dadit97/Razorback-Project/README.md

# Razorback Project
University project consisting of an Arduino controlled tank model

### Main Features

- LED lights
- Dynamic sound system
- Rotating turret
- Turret firing LEDs
- Programmable path to follow autonomously
- Bluetooth controlled

[Link to Overview](https://github.com/dadit97/Razorback-Project/blob/master/Documentation/Overview.md)<br>
[Link to Arduino code](https://github.com/dadit97/Razorback-Project/blob/master/Code/BluetoothController/BluetoothController.ino)<br>
[Link to Circuit Schema](https://github.com/dadit97/Razorback-Project/blob/master/Circuit%20Schema/Schema.md)
