dadit97/Razorback-Project/Documentation/Overview.md

# Table of contents

- [Introduction](#Introduction)
- [Model construction](#Body)
- [Sound System](#Sound)
- [Motors System](#Motors)
- [Power Source](#Power)
- [Compass module](#Compass)
- [Microcontroller](#Microcontroller)
- [Other components](#Other)

## Introduction 

The idea is to create a dynamic model of the Sci-Fi Armoured Personnel Carrier Razorback, from the WarHammer 40,000 game series.

|**Model to reproduce**|
|:--:|
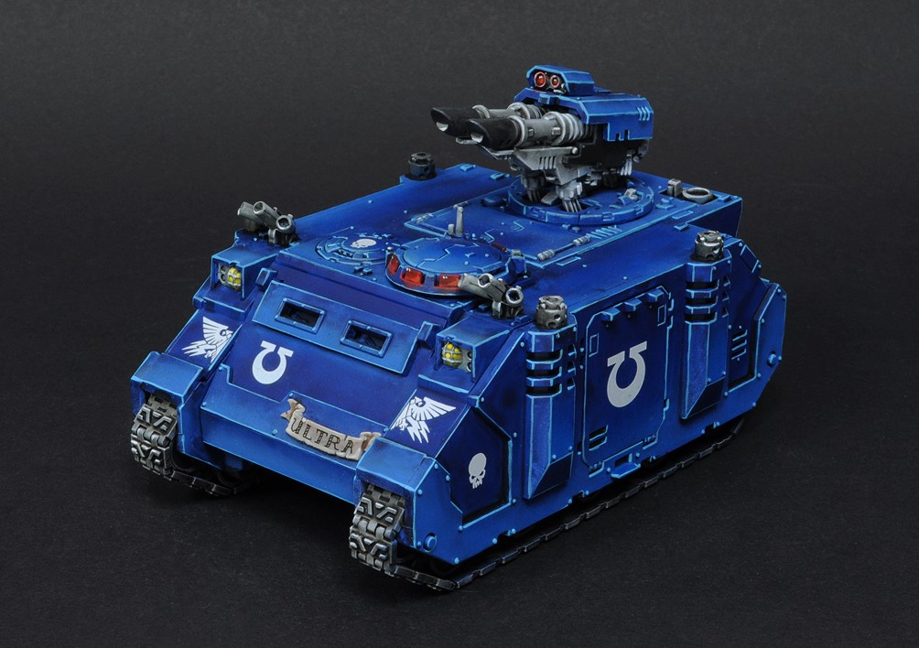
[picture p1: Images/Razorback.jpg]
||

The model, in addiction to being remotely controlled, should be able to follow a path he was instructed to patrol, using a compass as navigation aid and a distance sensor to avoid collisions.
This is an electronic project, so, the model will be simplified to some extent, but the objective is to create something that looks pretty similar.

## Model construction 

To build the chassis, the protection plates and the wheels I used some woodworking machines that I have access to. The dimensions have been estabilished by scaling some images knowing the total length and width of the model.

|**Main structure**||
|:--:|--|
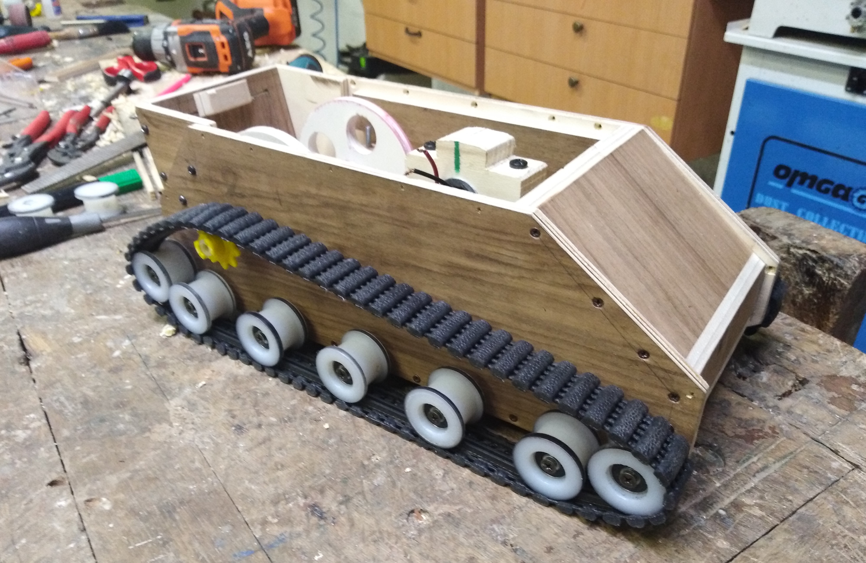
[picture p2: Images/Main_Structure.jpg]
||Inside the structure two pulleys were placed to reduce the speed of the main motors, these will transmit the power to the geared wheels,which were taken from an old Meccano kit. A structure to hold the motors in place has been installed in the middle of the body.|

|**Distance Sensor**||
|:--:|--|
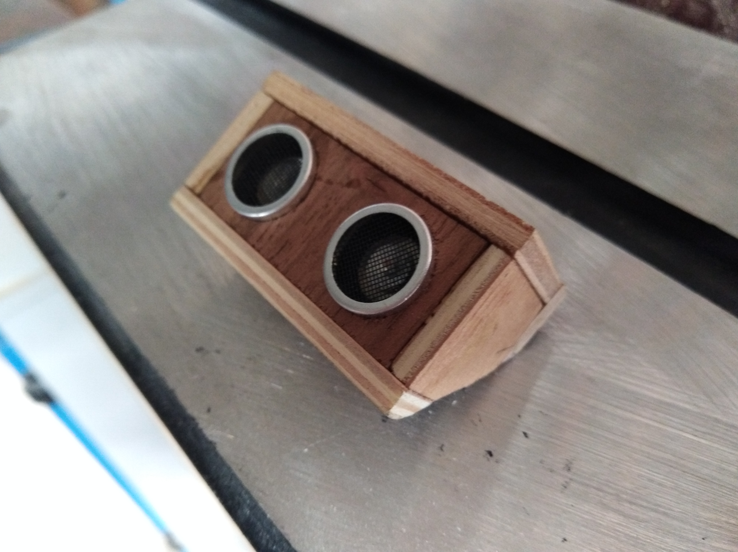
[picture p3: Images/Incapsulated_Sensor.jpg]
||The distance sensor had to be placed on the front, so it was closed in a proper case.|

Then the turret was built creating the servomotor housing inside and creating room for the firing LEDs. Unfortunately, the micro servo doesn't have a robust axle, so the connection is not the best, but for its purpose is enough.

The remaining of the building work were just the various decorations to make it similar to the target.

|**Components used and result after spray painting**|
|:--:|
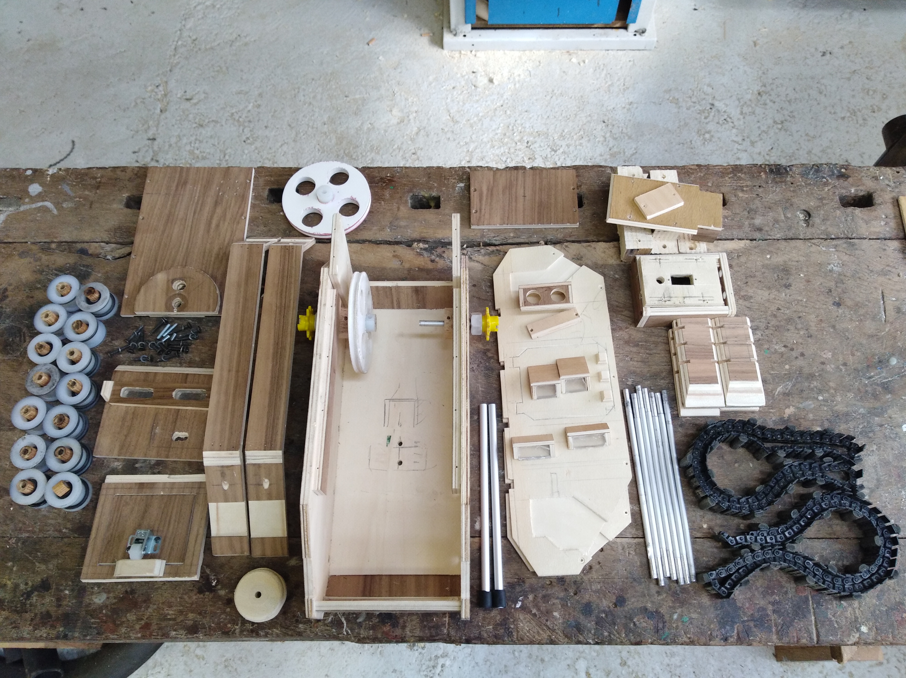
[picture p4: Images/Pieces.jpg]
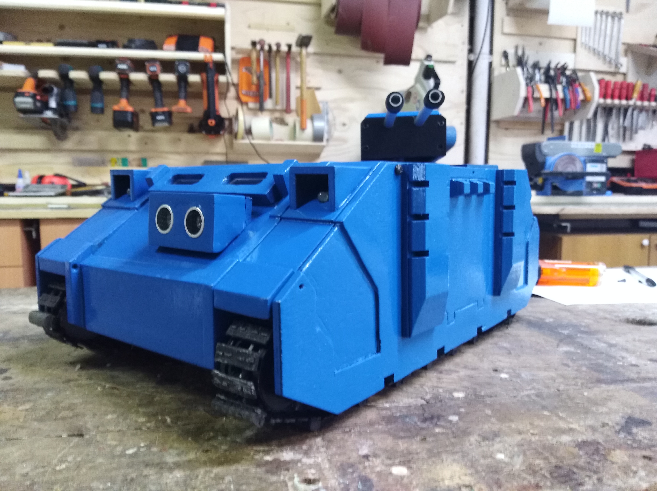
[picture p5: Images/Result.jpg]
|  |

|**Final aspect with lights on**|
|:--:|
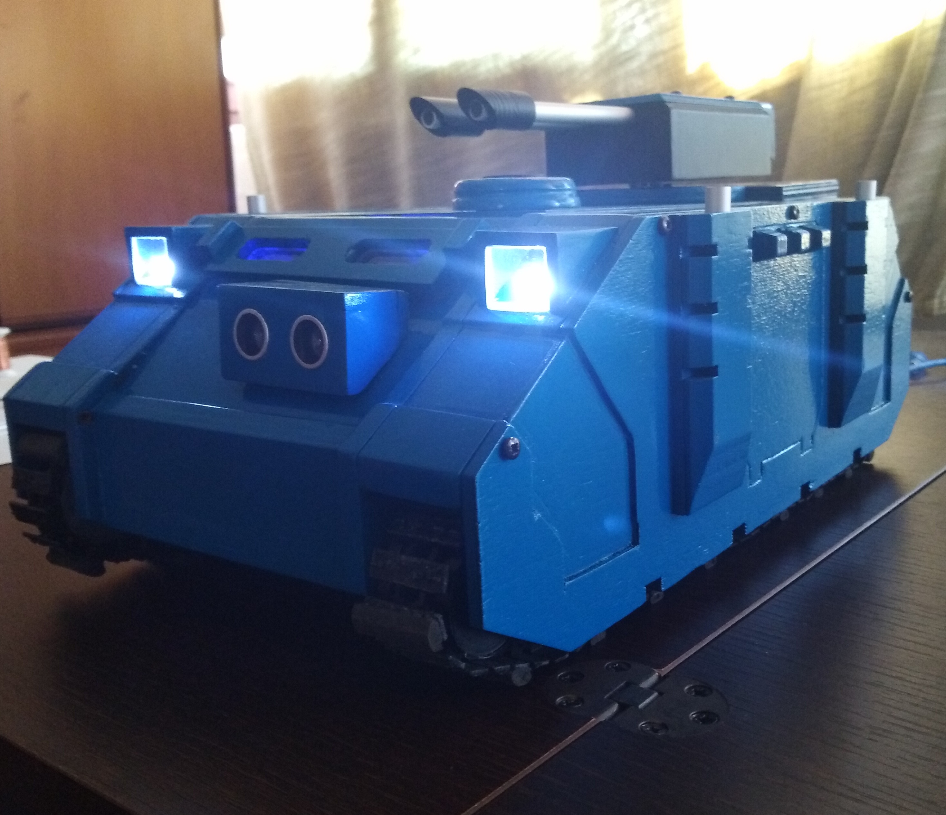
[picture p6: Images/Final_Front.jpg]
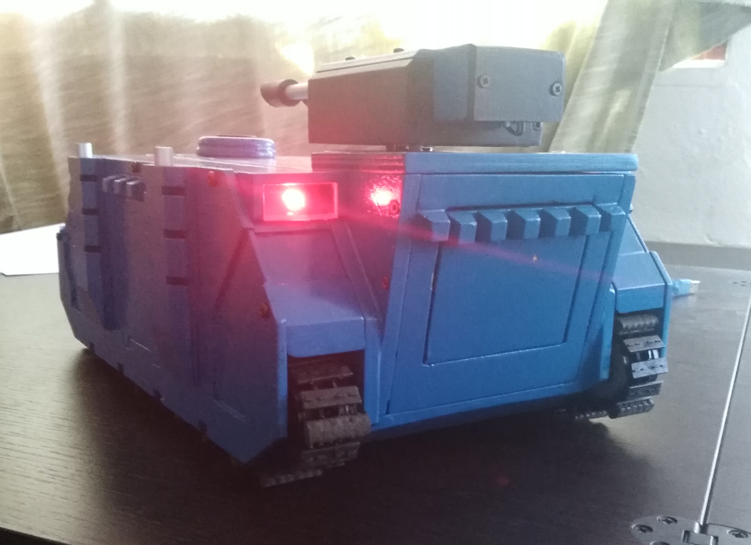
[picture p7: Images/Final_Back.jpg]
|  |

## Power Source 

|**Battery**||
|:--:|--|
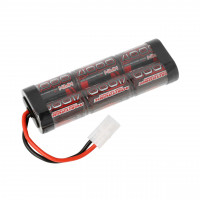
[picture p8: Images/Battery.jpg]
||The model will be powered up by a rechargable NI-MH 7.2V battery.|

## Sound System 

|**MP3 module**|**Speaker**||
|:--|:--:|--:|
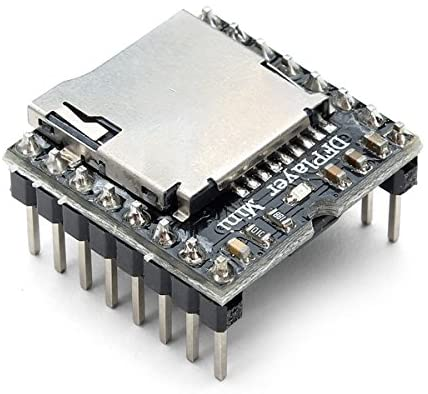
[picture p9: Images/DF_Mini.jpg]
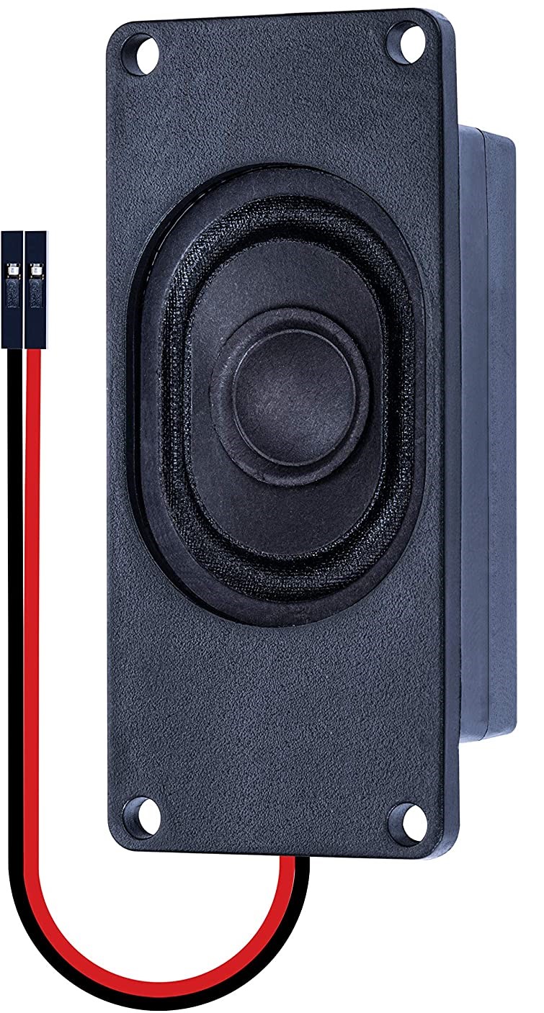
[picture p10: Images/Speaker.jpg]
| ||To create the illusion of the engine rumble, a MP3 module has been added to the control system, connected to a tiny 3W speaker, which is the maximum power that the module can supply without an amplifier.|

The module will be instructed by the Arduino using Serial communication, which will change the sound to be reproduced to suit the state of the model.
The storage of the module is a microSD card, in which the looped sounds were loaded.

## Motors System 

At the beginning of the project, the propulsion was based on two small 3-6V DC motors, but during the construction, the model's weigth showed clearly that this solution was unacceptable.

|**Motors used**||
|:--:|--|
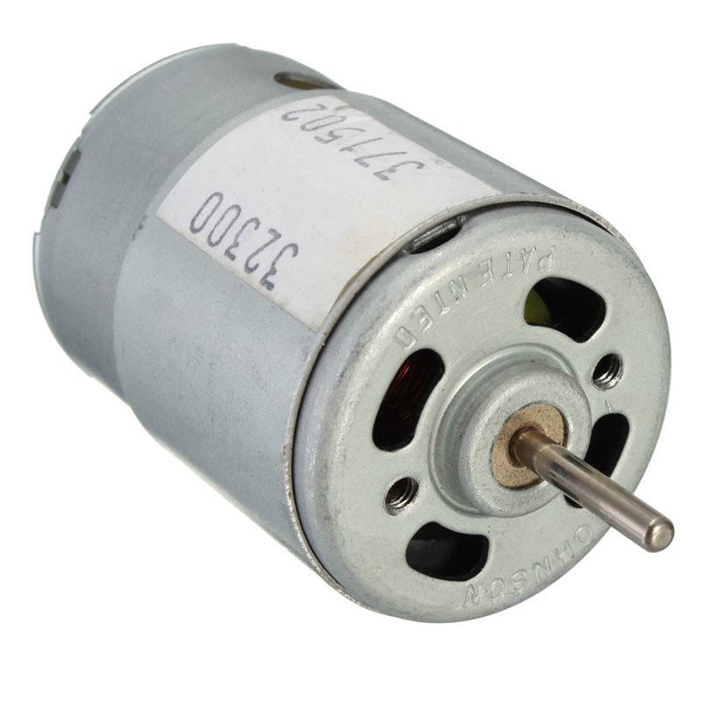
[picture p11: Images/9V_Motor.jpg]
||According to this requirement, the little motors had been replaced by two 9V DC motors, which can provide the torque required to move the tank at a reasonable speed.|

After the replacing another problem arose, the motor driver.
The driver chosen was the classic L298N, basically the standard for<br> Arduino-powered moving projects.

|**L298N**||
|:--:|--|
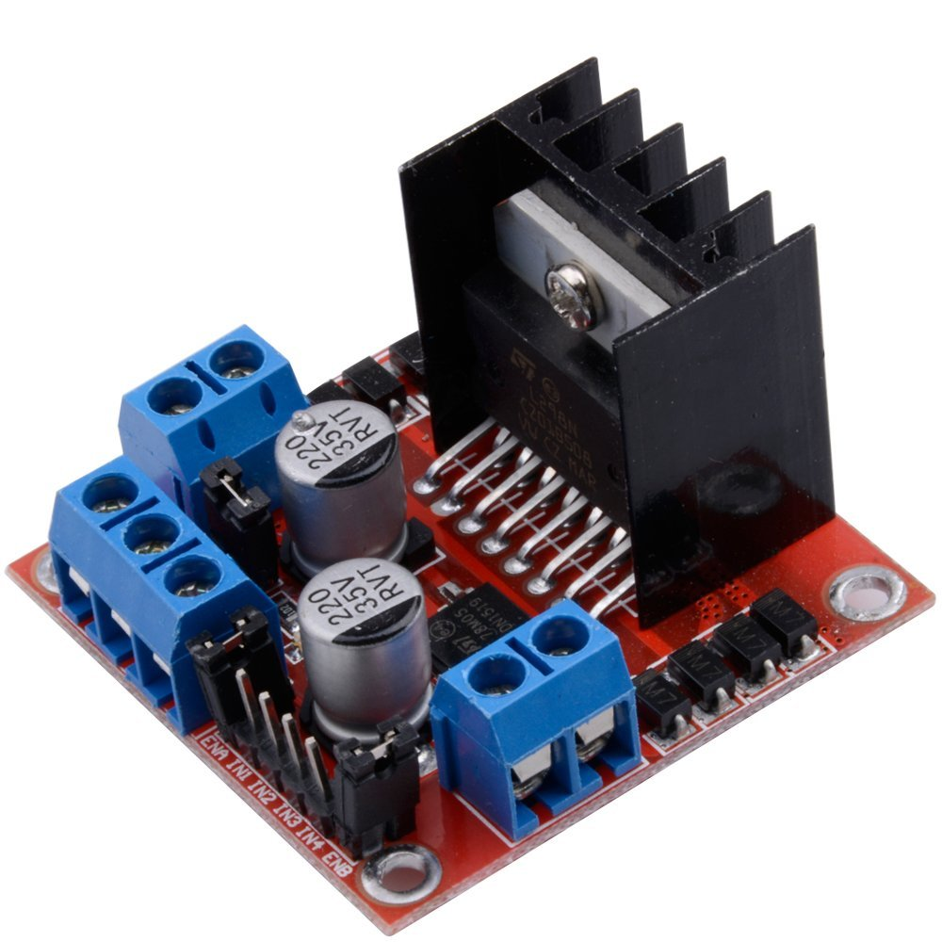
[picture p12: Images/L298N.jpg]
||This double motor driver, unfortunately, can provide just 2 Ampere for channel, which is enough for 3-6V motors, but too low for something bigger.According to a multimeter test, the motors can use up to 5.6 Ampere at stall load, so even using one driver per motor by bridging the outputs (a solution that creates a lot of redundancy in the circuit), was not enough.|

|**IRF3205 Double Motor Driver**||
|:--:|--|
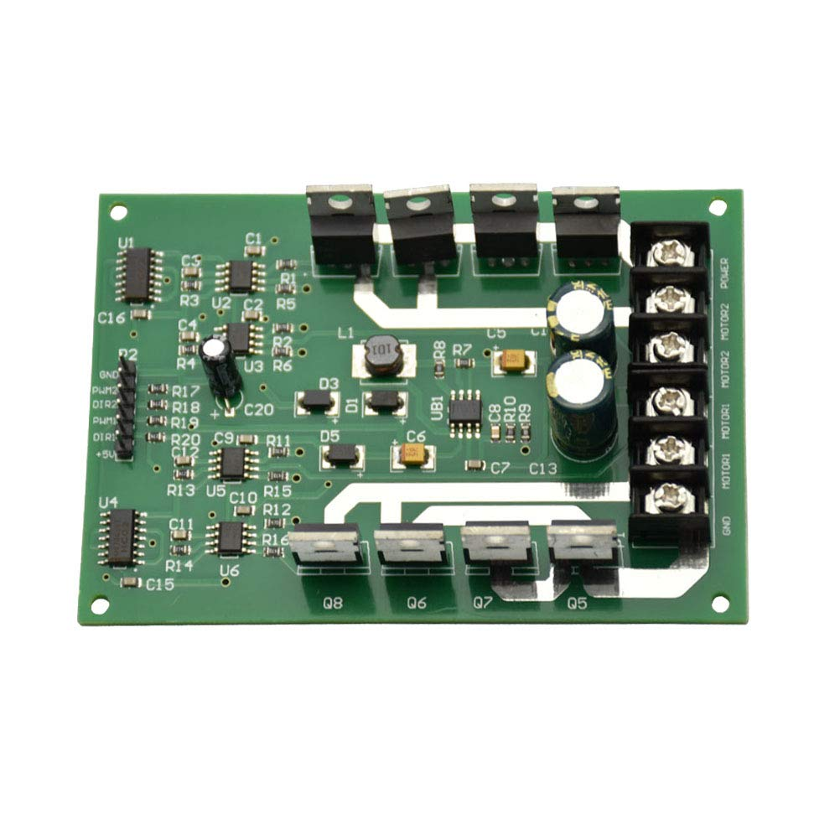
[picture p13: Images/Double_Motor_Driver.jpg]
||The driver chosen the replace the inadequate one is a 15 Ampere double motor driver, equipped with MOSFET bridges, wich allowed the motor to use the full power provided by the battery without the danger of overheating the chip.|

## Compass module 

|**GY-271 Electronic Compass**||
|:--:|--|
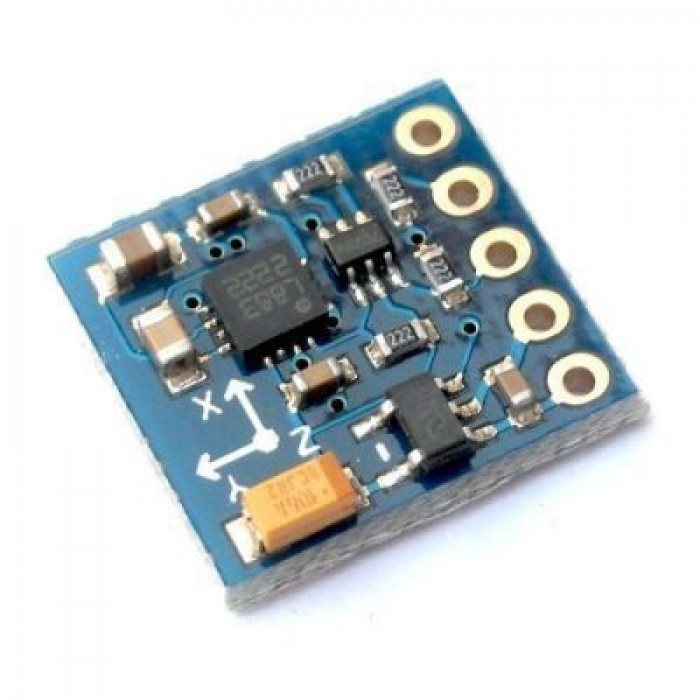
[picture p14: Images/GY-271.jpg]
||To implement the autonomus movement along a path, the tank has been equipped with an electronic compass. Via I2C communication it will provide the heading information to the Arduino, so the model will be able to control its direction with a good amount of accuracy.

## Microcontroller 

|**Arduino Uno R3**||
|:--:|--|
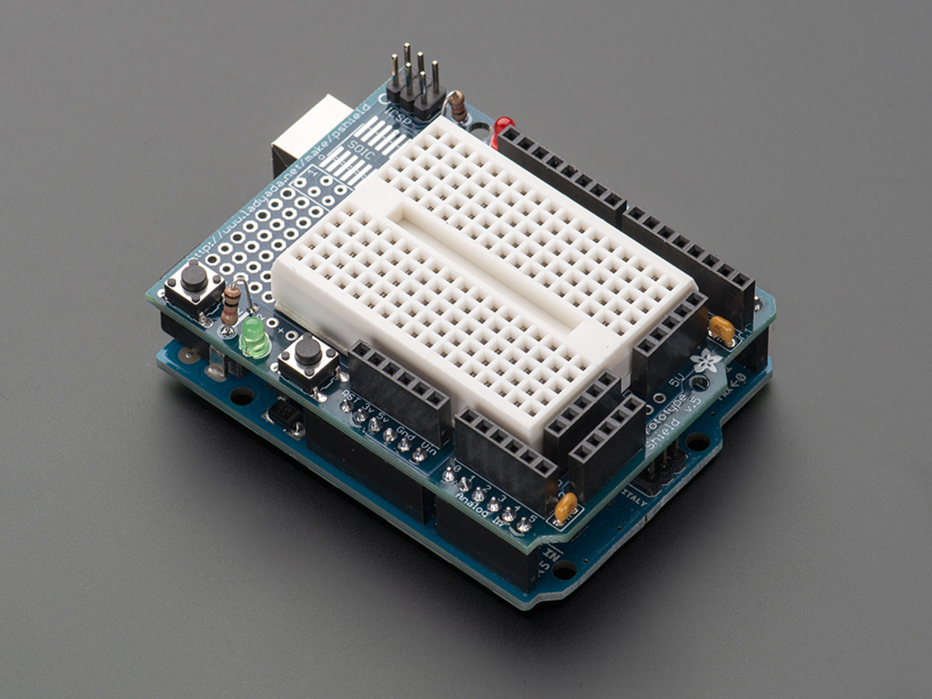
[picture p15: Images/Prototyping_Module.jpg]
||In the initial stages of the project, the idea was to use a normal Arduino Uno supported by a mini breadboard, but, the small amount of space remained for it, suggested that something smaller was necessary. So the microcontroller was fitted with a Prototyping Module, which provides more Ground and Power connections, along with making the unit more compact.

|**HC-05 Bluetooth Module**||
|:--:|--|
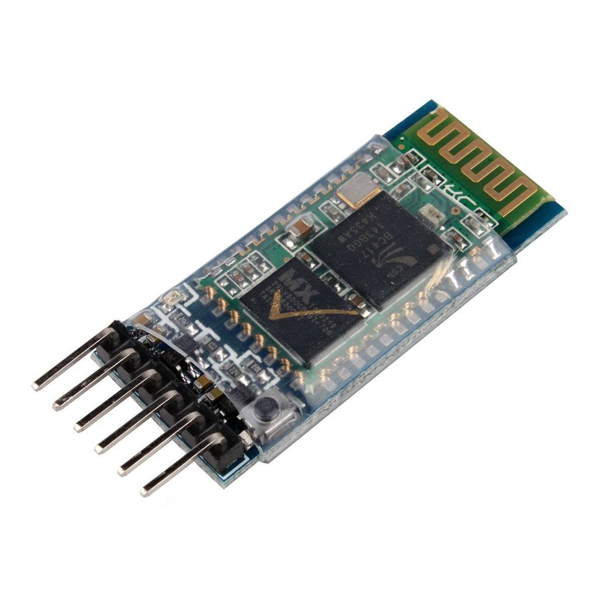
[picture p16: Images/HC-05.jpg]
||The various commands will be sent to the tank via Bluetooth, using an Android application, this module will collect them and, using Serial communication, send the instructions to the microcontroller.

## Other components 

To create the complete circuit some basic electronic components were necessary, like LEDs, jumper wires, electric cables, resistors, NPN transistors(for the lights circuit), and a 5V voltage regulator for the turret Servo.

||
|:--:|
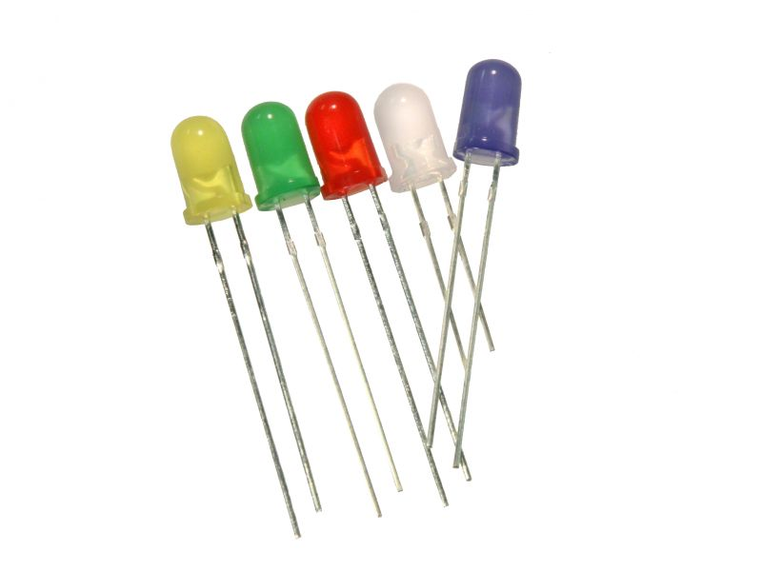
[picture p17: Images/LEDs.jpg]
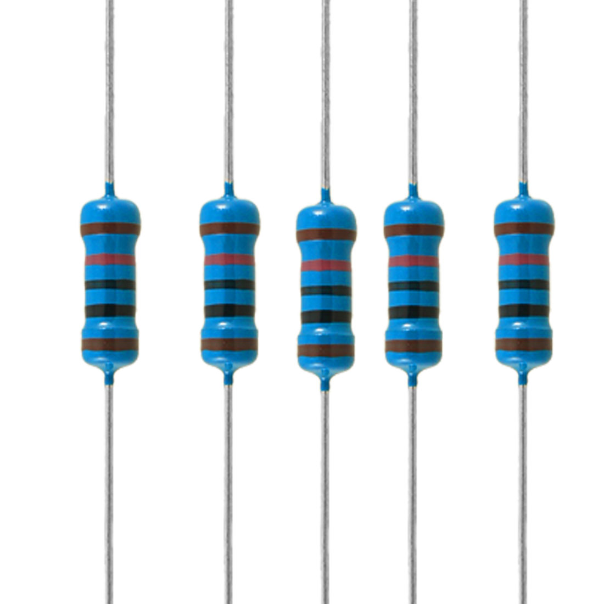
[picture p18: Images/Resistors.jpg]
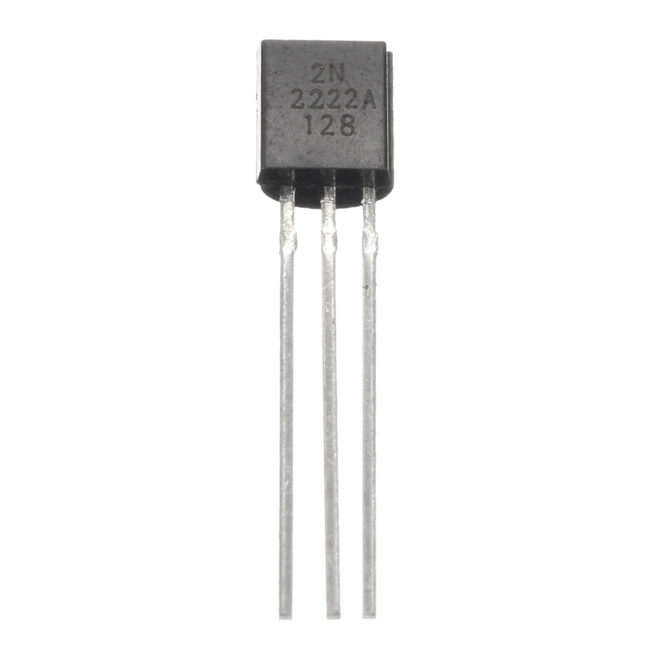
[picture p19: Images/2222A_Transistor.jpg]
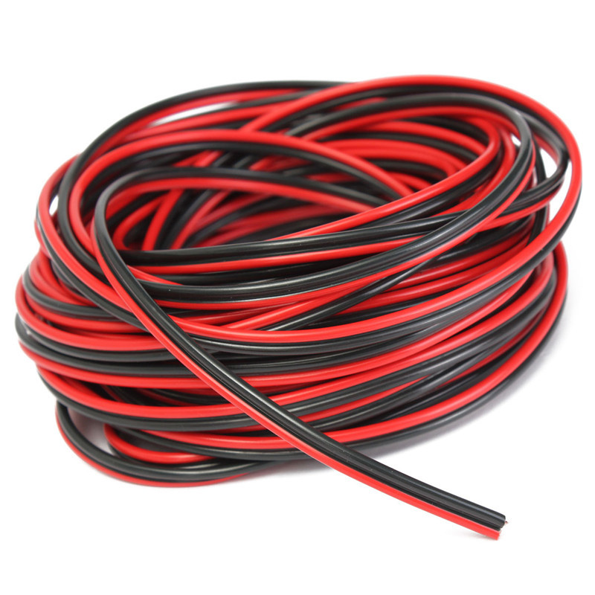
[picture p20: Images/Cables.jpg]
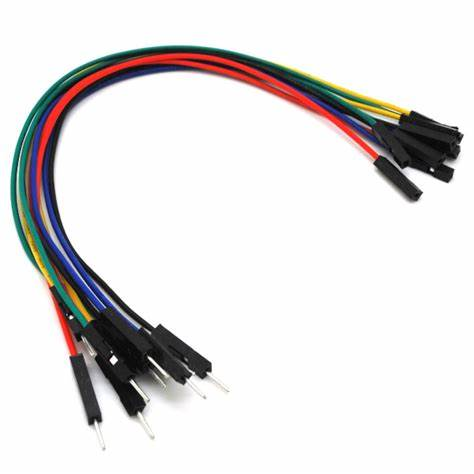
[picture p21: Images/Jumpers.jpg]
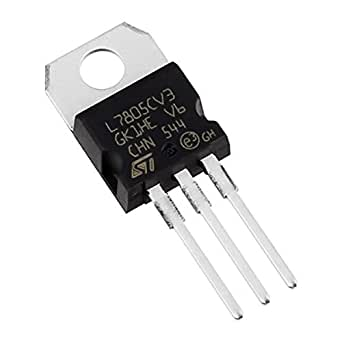
[picture p22: Images/L7805.jpg]
|     |

[Link to Arduino code](https://github.com/dadit97/Razorback-Project/blob/master/Code/BluetoothController/BluetoothController.ino)<br>
[Link to Circuit Schema](https://github.com/dadit97/Razorback-Project/blob/master/Circuit%20Schema/Schema.md)<br>
[Link to Control Interface](https://github.com/dadit97/Razorback-Project/blob/master/Documentation/Interface.md)
