dadit97/Razorback-Project/Images/3V_motor.jpg

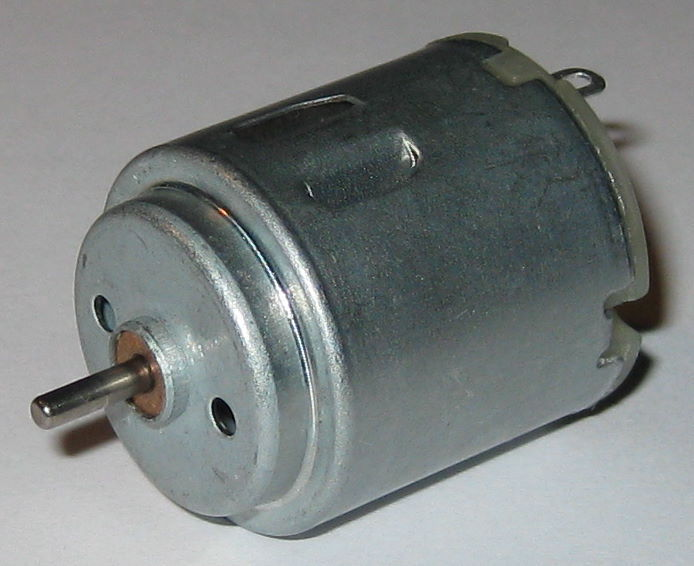
Images/3V_motor.jpg
