dadit97/Razorback-Project/Images/Elegoo_Uno.jpg

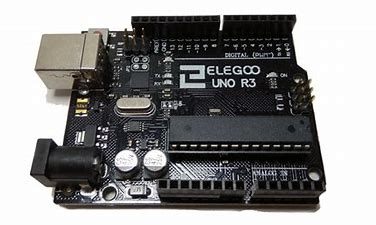
Images/Elegoo_Uno.jpg
