dadit97/Razorback-Project/Images/HCSR04.jpg

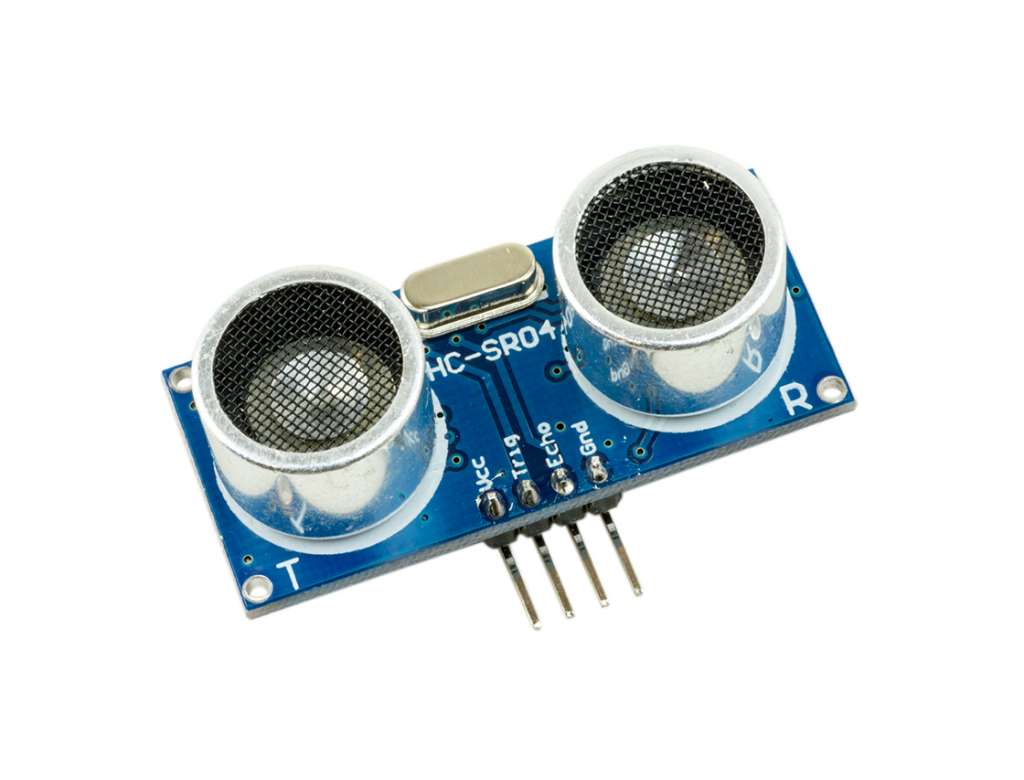
Images/HCSR04.jpg
