dadit97/Razorback-Project/Images/SG90.jpg

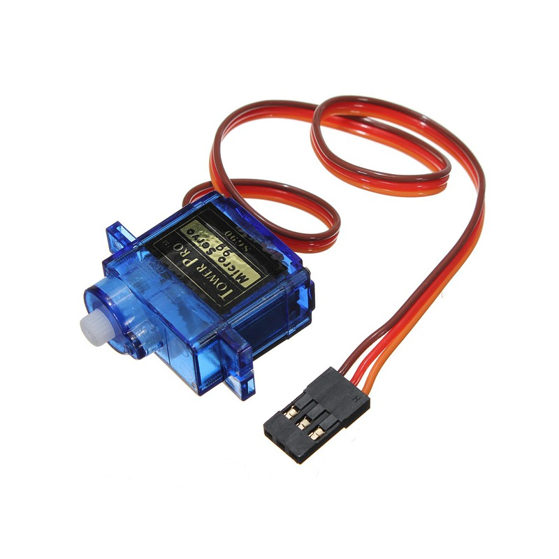
Images/SG90.jpg
