dadit97/Razorback-Project/(commit log)

2020-07-02 Motors added
2020-07-09 Circuit Schema added
2020-07-21 Voltage Regulator added
